elektrofuzzis/ftPwrDrive/wikifiles/img/poti.png

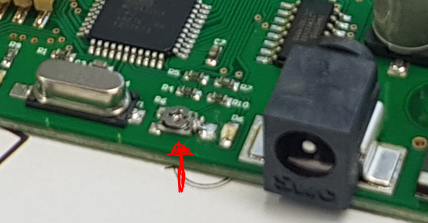
wikifiles/img/poti.png
