elektrofuzzis/ftPwrDrive/wikifiles/img/ROBOPro/microstepping.png

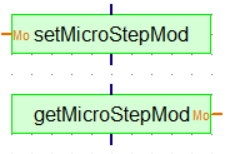
wikifiles/img/ROBOPro/microstepping.png
