elektrofuzzis/ftPwrDrive/README.md

# ftPwrDrive
The ftPwrDrive is a i²c based stepper motor driver for fischertechnik, Arduino &amp; Raspberry. The project contains the stepper motor drivers hardware, the firmware and interface libraries to use the hardware with multiple plattforms.

Please checkout the <a href="https://github.com/elektrofuzzis/ftPwrDrive/wiki">online manual</a>. Since the hardware is a complex smd pcb, you could buy a plug&play device at <a href="https://gundermann-software.de/shop/">gundermann.org</a>.

To check out the latest releases please follow up the <a href="https://github.com/elektrofuzzis/ftPwrDrive/wiki/Changelog">version history</a>.

<hr width="100%" />

Der ftPwrDrive ist ein Schrittmotortreiber für fischertechnik, Arduino &amp; Raspberry auf i²C-Basis. Das Projekt beinhaltet sowohl doe Schrittmotortreiberhardware und die notwendige Firmware als auch Interface Bibliotheken für unterschiedliche Plattformen.

Bitte lesen Sie das <a href="https://github.com/elektrofuzzis/ftPwrDrive/wiki">Online Manual</a>. Die Hardware besteht aus einer komplexen, SMD-bestückten Platine. Sie können den ftPwrDrive auch als fertiges Gerät bei <a href="https://gundermann-software.de/shop/">gundermann.org</a> bestellen.

Das Changelog für die aktuelle Version finden sie<a href="https://github.com/elektrofuzzis/ftPwrDrive/wiki/Changelog"> hier</a>.
