elektrofuzzis/ftPwrDrive/Arduino Library/readme.txt

To connect a ftPwrDrive to an Arduino board, please use the ftDuino implementation.
