elektrofuzzis/ftPwrDrive/wikifiles/img/arduino/motor_const.png

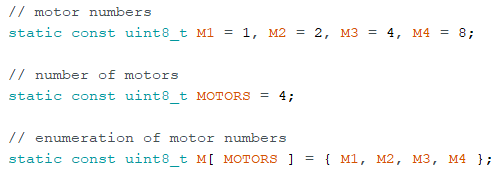
wikifiles/img/arduino/motor_const.png
