elektrofuzzis/ftPwrDrive/wikifiles/img/arduino/snippet2.png

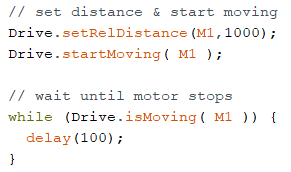
wikifiles/img/arduino/snippet2.png
