elektrofuzzis/ftPwrDrive/wikifiles/img/arduino/snippet3.png

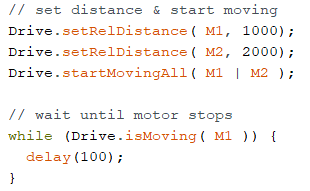
wikifiles/img/arduino/snippet3.png
