elektrofuzzis/ftPwrDrive/wikifiles/img/arduino/snippet8.png

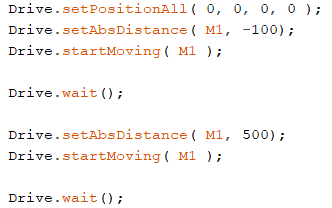
wikifiles/img/arduino/snippet8.png
