elektrofuzzis/ftPwrDrive/wikifiles/img/arduino/snippet9.png

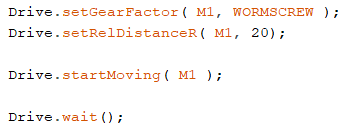
wikifiles/img/arduino/snippet9.png
