elektrofuzzis/ftPwrDrive/wikifiles/img/robopro1.png

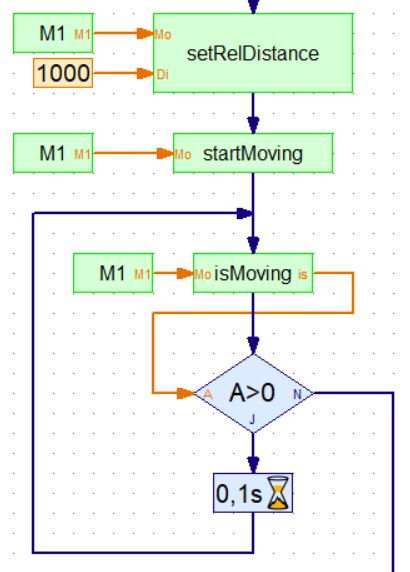
wikifiles/img/robopro1.png
