elektrofuzzis/ftPwrDrive/wikifiles/img/ROBOPro/gear_const.png

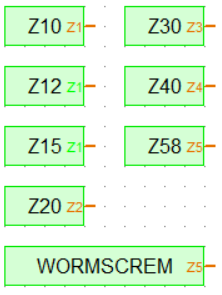
wikifiles/img/ROBOPro/gear_const.png
