elektrofuzzis/ftPwrDrive/wikifiles/img/ROBOPro/getPosition.png

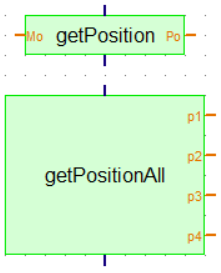
wikifiles/img/ROBOPro/getPosition.png
