elektrofuzzis/ftPwrDrive/wikifiles/img/ROBOPro/homing.png

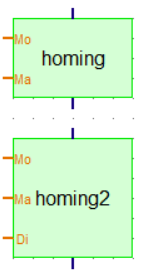
wikifiles/img/ROBOPro/homing.png
