elektrofuzzis/ftPwrDrive/wikifiles/img/ROBOPro/isMoving.png

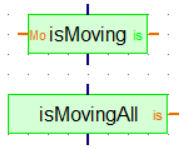
wikifiles/img/ROBOPro/isMoving.png
