elektrofuzzis/ftPwrDrive/wikifiles/img/ROBOPro/microstepping_const.png

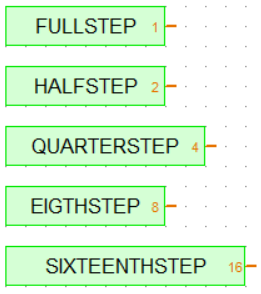
wikifiles/img/ROBOPro/microstepping_const.png
