elektrofuzzis/ftPwrDrive/wikifiles/img/ROBOPro/setAbsDistance.png

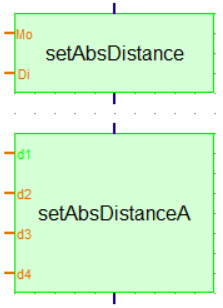
wikifiles/img/ROBOPro/setAbsDistance.png
