elektrofuzzis/ftPwrDrive/wikifiles/img/ROBOPro/setPosition.png

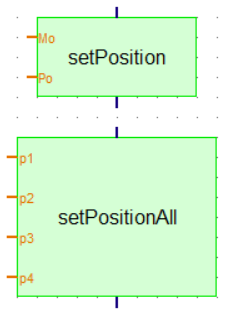
wikifiles/img/ROBOPro/setPosition.png
