elektrofuzzis/ftPwrDrive/wikifiles/img/ROBOPro/setRelDistance.png

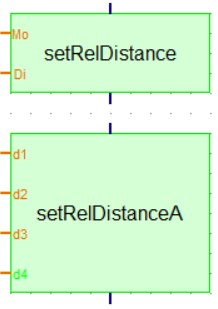
wikifiles/img/ROBOPro/setRelDistance.png
