elektrofuzzis/ftPwrDrive/wikifiles/img/ROBOPro/snippet1.png

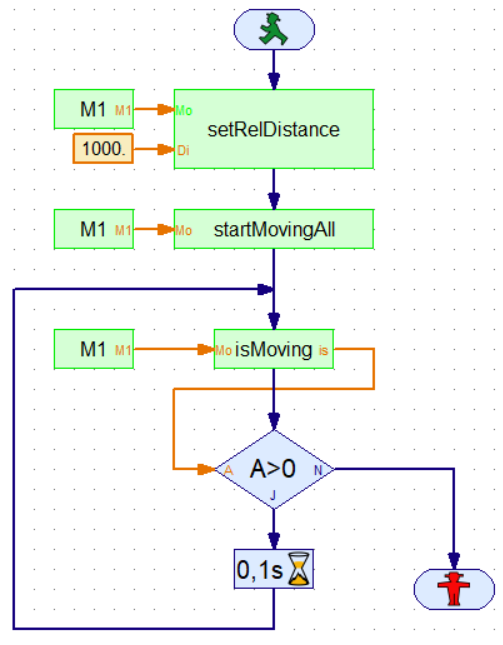
wikifiles/img/ROBOPro/snippet1.png
