elektrofuzzis/ftPwrDrive/wikifiles/img/ROBOPro/snippet2.png

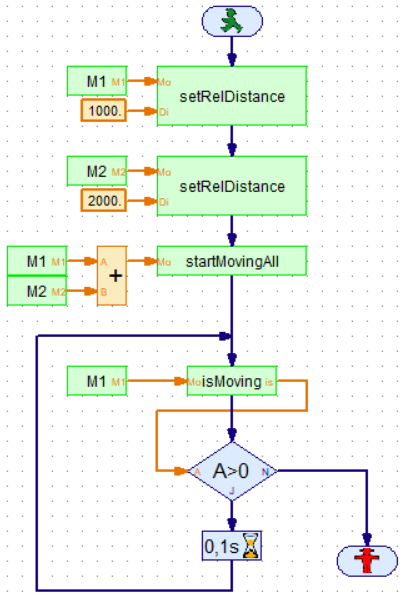
wikifiles/img/ROBOPro/snippet2.png
