elektrofuzzis/ftPwrDrive/wikifiles/img/ROBOPro/snippet3.png

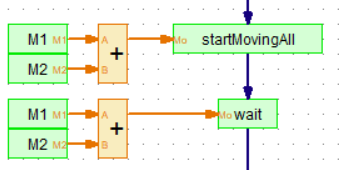
wikifiles/img/ROBOPro/snippet3.png
