elektrofuzzis/ftPwrDrive/wikifiles/img/ROBOPro/snippet5.png

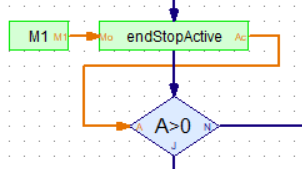
wikifiles/img/ROBOPro/snippet5.png
