elektrofuzzis/ftPwrDrive/wikifiles/img/ROBOPro/snippet6.png

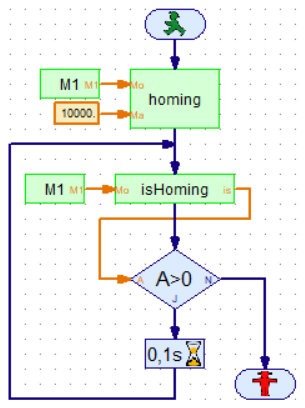
wikifiles/img/ROBOPro/snippet6.png
