elektrofuzzis/ftPwrDrive/wikifiles/img/ROBOPro/snippet7.png

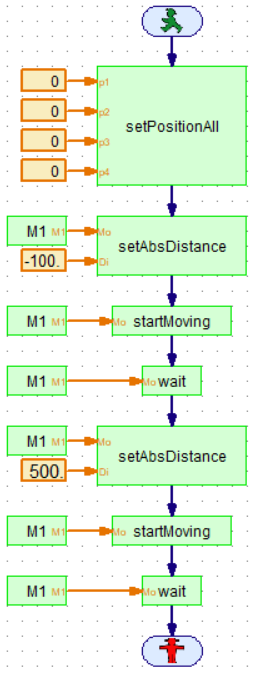
wikifiles/img/ROBOPro/snippet7.png
