elektrofuzzis/ftPwrDrive/wikifiles/img/ROBOPro/snippet8.png

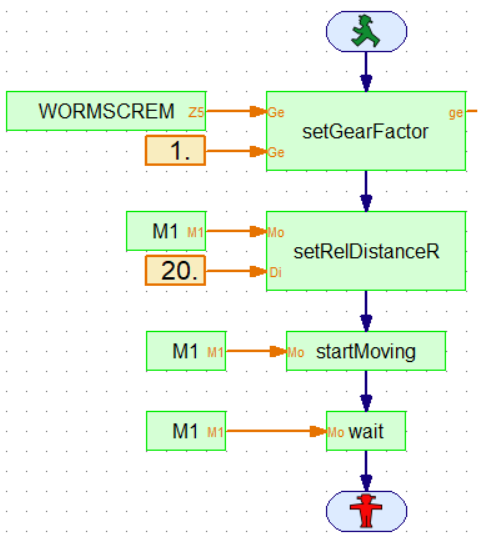
wikifiles/img/ROBOPro/snippet8.png
