elektrofuzzis/ftPwrDrive/wikifiles/img/ROBOPro/snippet10.png

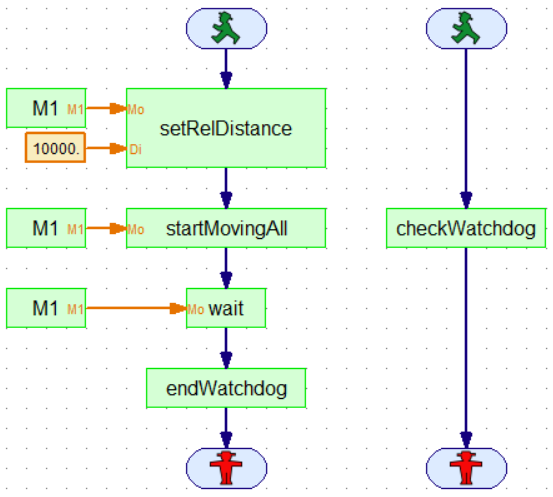
wikifiles/img/ROBOPro/snippet10.png
