elektrofuzzis/ftPwrDrive/wikifiles/img/ROBOPro/startMoving.png

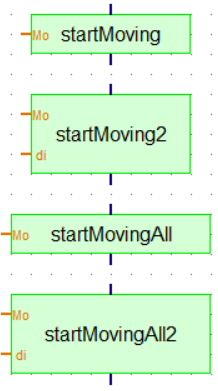
wikifiles/img/ROBOPro/startMoving.png
