elektrofuzzis/ftPwrDrive/wikifiles/img/ROBOPro/stopMoving.png

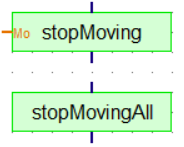
wikifiles/img/ROBOPro/stopMoving.png
