elektrofuzzis/ftPwrDrive/wikifiles/img/ROBOPro/watchdog.png

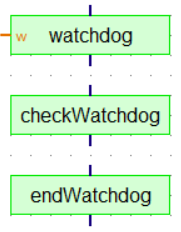
wikifiles/img/ROBOPro/watchdog.png
