elektrofuzzis/ftPwrDrive/wikifiles/img/servo1.png

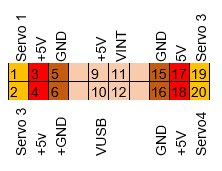
wikifiles/img/servo1.png
