elektrofuzzis/ftPwrDrive/wikifiles/img/maintenance.png

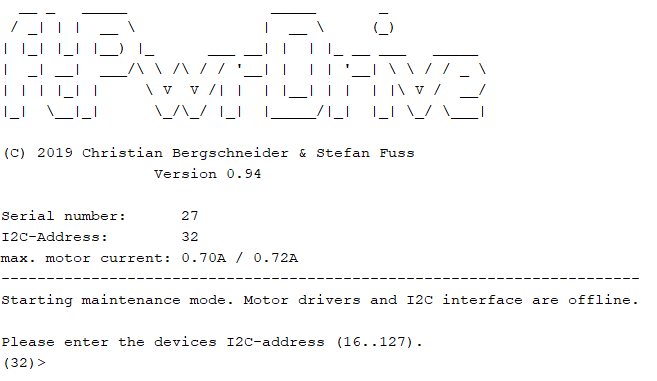
wikifiles/img/maintenance.png
