elektrofuzzis/ftPwrDrive/Hardware/Schematic/Schematic_Diagram.pdf

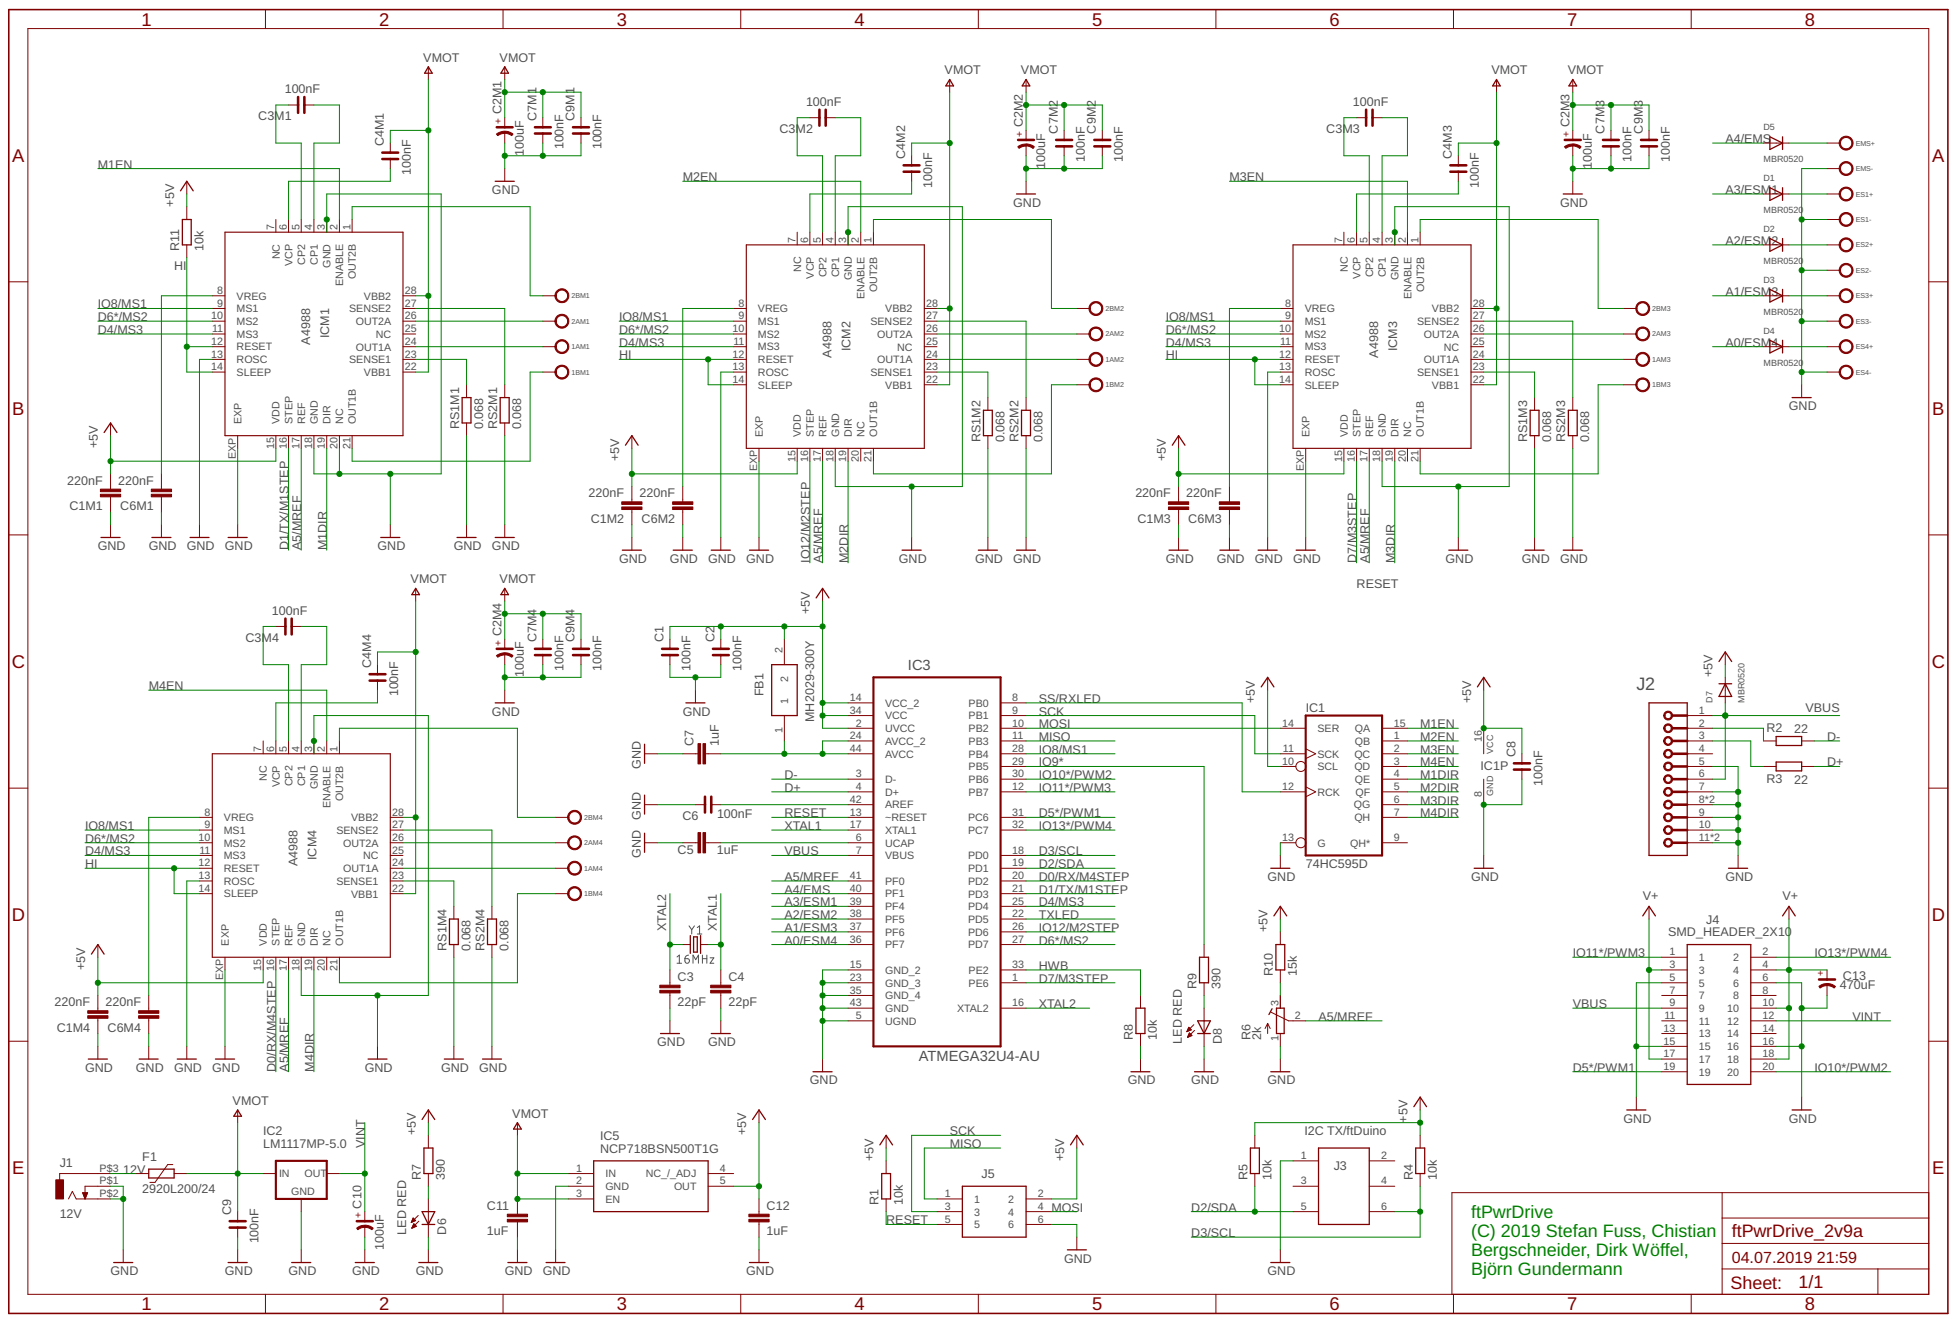
[picture p39: page 1]

LED RED GND ATMEGA32U4-AU

ftPwrDrive
(C) 2019 Stefan Fuss, Chistian Bergschneider, Dirk Wöffel, Björn Gundermann
