elektrofuzzis/ftPwrDrive/Hardware/Schematic/Layout.pdf

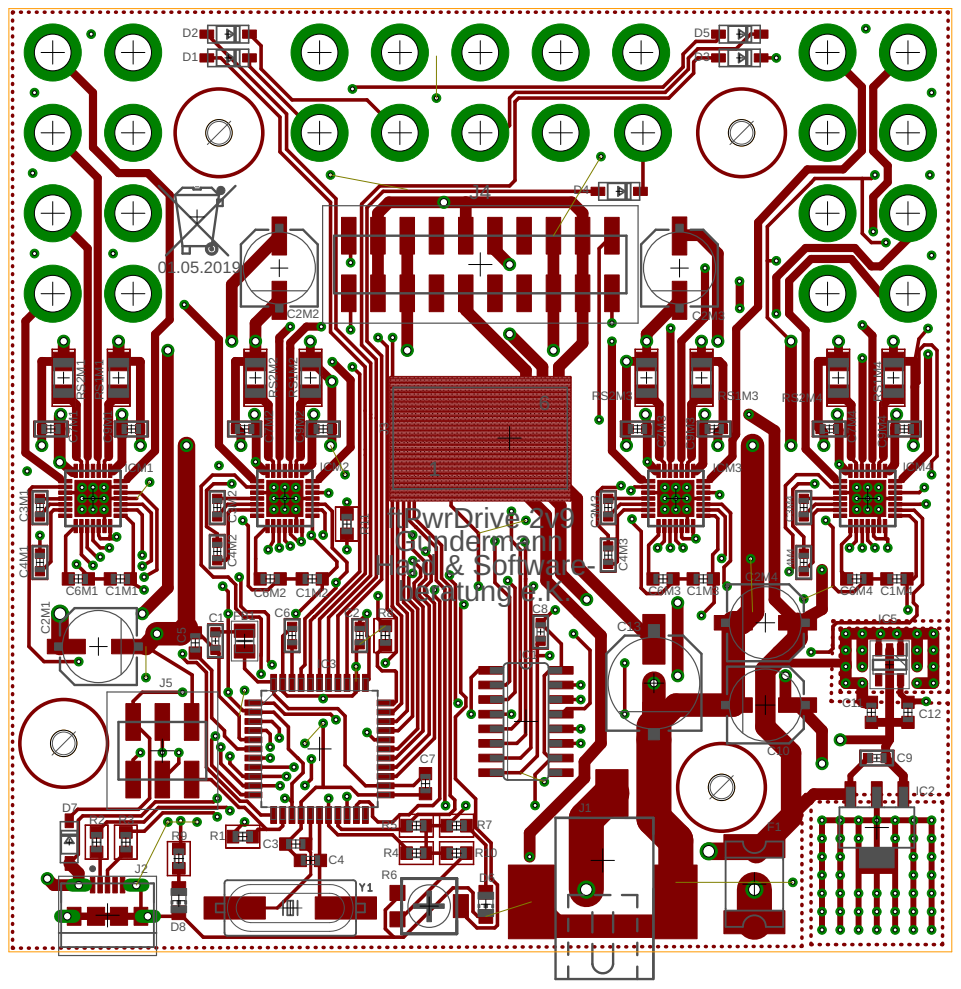
[picture p40: page 1]
