elektrofuzzis/ftPwrDrive/Hardware/Schematic/ftPwrDrive_2v9a.brd

## EAGLE design Hardware/Schematic/ftPwrDrive_2v9a.brd (2019-08-30)

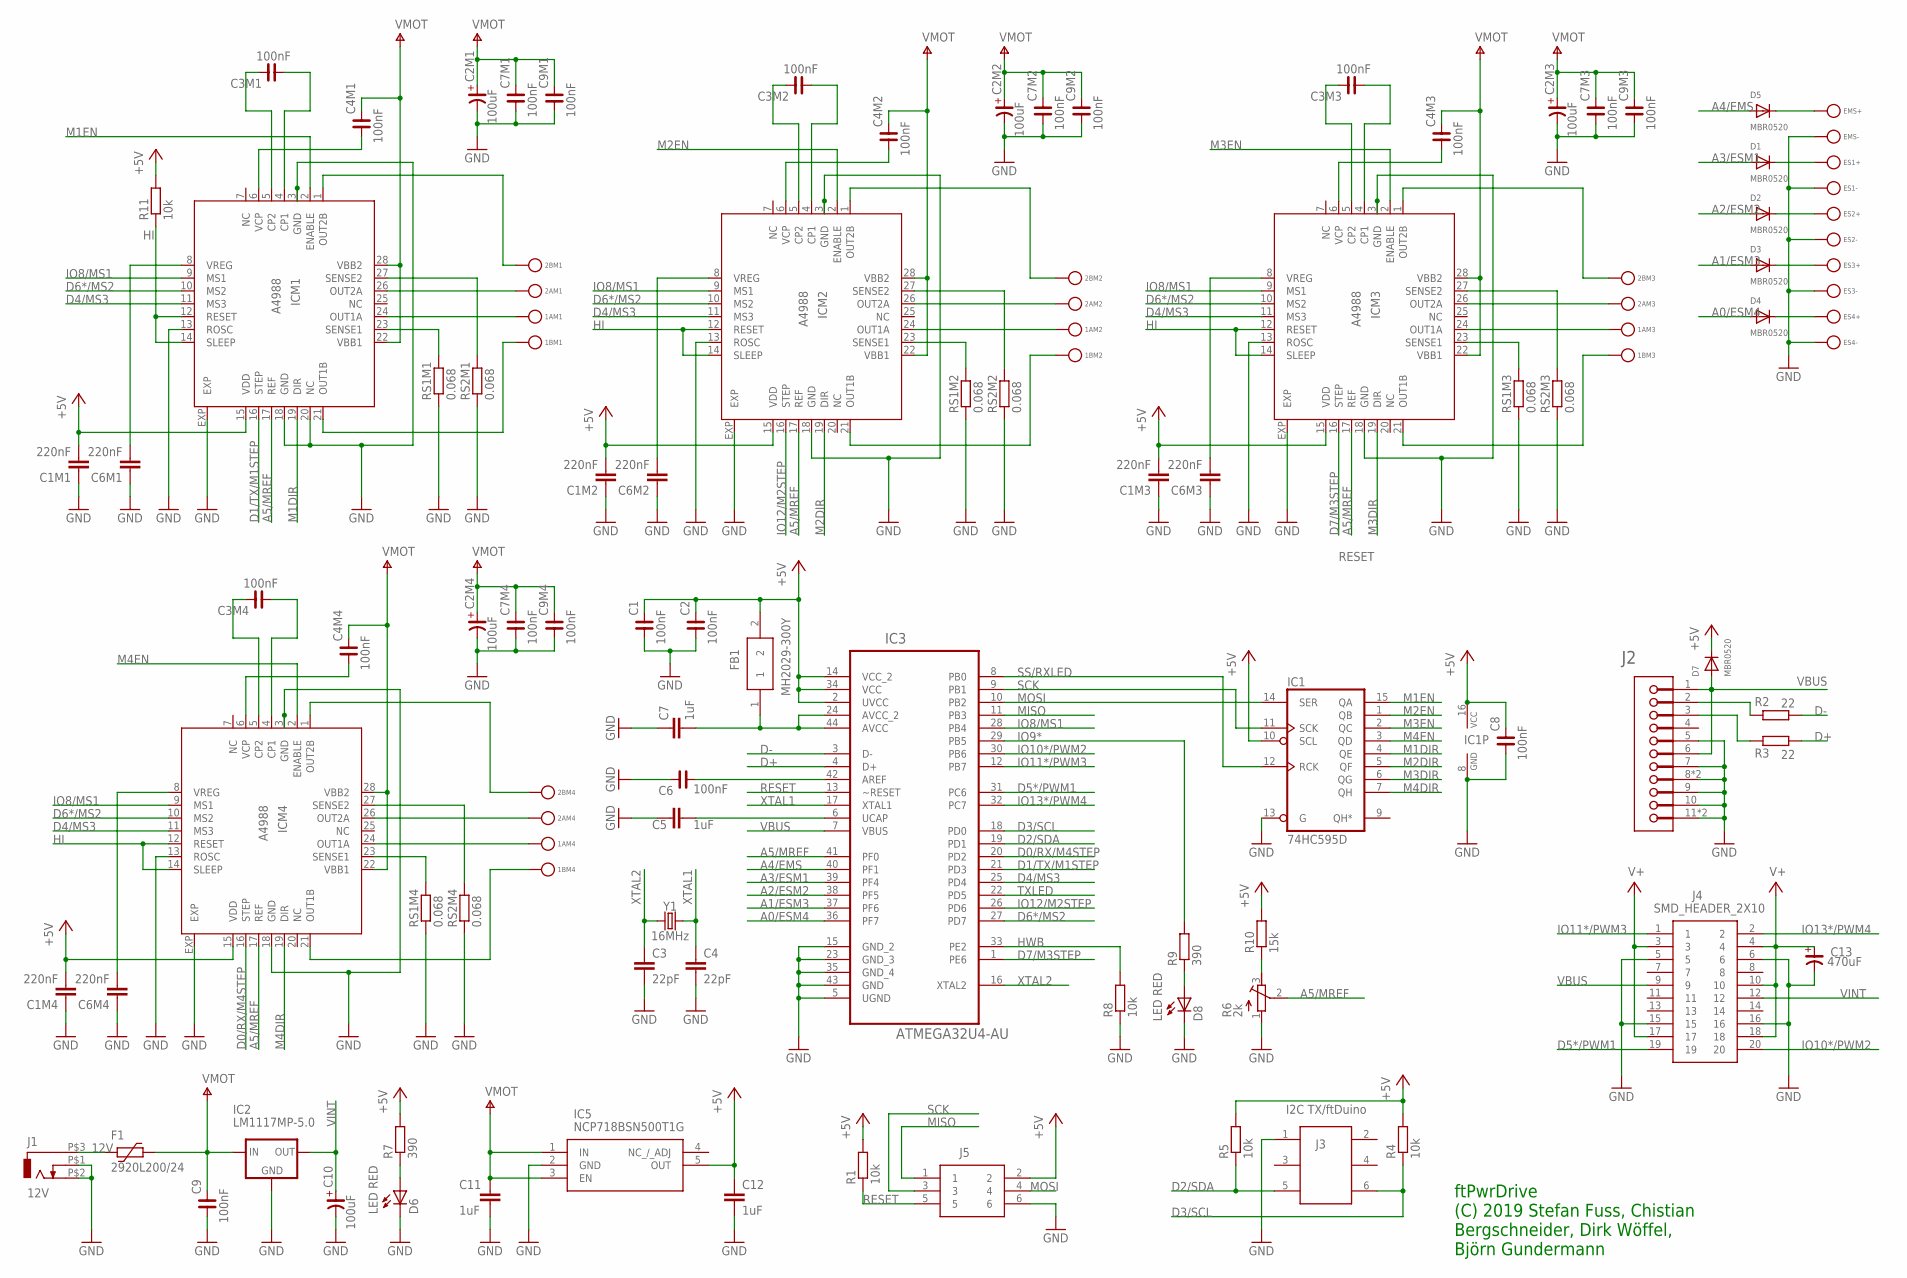
[picture p41: schematic ftPwrDrive_2v9a.sch]

Parts:
1AM1, 1AM2, 1AM3, 1AM4, 1BM1, 1BM2, 1BM3, 1BM4, 2AM1, 2AM2, 2AM3, 2AM4, 2BM1, 2BM2, 2BM3, 2BM4: BUNDHUELSE2; BUNDHUELSE
C1, C2, C3M1, C3M2, C3M3, C3M4, C4M1, C4M2, C4M3, C4M4, C6, C7M1, C7M2, C7M3, C7M4, C8, C9, C9M1, C9M2, C9M3, C9M4: 100nF; C0603
C1M1, C1M2, C1M3, C1M4, C6M1, C6M2, C6M3, C6M4: 220nF; C0603K
C2M1, C2M2, C2M3, C2M4, C10: 100uF; CSV-D
C3, C4: 22pF; C0603K
C5, C7, C11, C12: 1uF; C0603K
C13: 470uF; CSV-E/F
D1, D2, D3, D4, D5, D7: MBR0520; SOD-123
D6, D8: LED RED; CHIP-LED0805
EMS+: BUNDHUELSE2; BUNDHUELSE
EMS-: BUNDHUELSE2; BUNDHUELSE
ES1+, ES1-, ES2+, ES2-, ES3+, ES3-, ES4+, ES4-: BUNDHUELSE2; BUNDHUELSE
F1: 2920L200/24; 2920L
FB1: MH2029-300Y; BEADC2016X130N
IC1: 74HC595D; SO16
IC2: LM1117MP-5.0; SOT223
IC3: ATMEGA32U4-AU; QFP80P1200X1200X120-44N
IC5: NCP718BSN500T1G; SOT95P280X100-5N
ICM1, ICM2, ICM3, ICM4: A4988; QFN28ET
J1: 12V; RASM7X2
J2: AMPHENOL_10118194-0001LFAMPHENOL_10118194-0001LF_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; AMPHENOL_10118194-0001LF_0
J3: I2C TX/ftDuino; SMTHEADER06
J4: SMD_HEADER_2X10
J5: SMD_HEADER_2X03
R1, R4, R5, R8, R11: 10k; R0603
R2, R3: 22; R0603
R6: 2k; RTRIM4G/J
R7, R9: 390; R0603
R10: 15k; R0603
RS1M1, RS1M2, RS1M3, RS1M4, RS2M1, RS2M2, RS2M3, RS2M4: 0.068; R1206
Y1: 16MHz; HC49UP

Connections:
1AM1: 1AM1.P$1, ICM1.24 (OUT1A)
1AM2: 1AM2.P$1, ICM2.24 (OUT1A)
1AM3: 1AM3.P$1, ICM3.24 (OUT1A)
1AM4: 1AM4.P$1, ICM4.24 (OUT1A)
1BM1: 1BM1.P$1, ICM1.21 (OUT1B)
1BM2: 1BM2.P$1, ICM2.21 (OUT1B)
1BM3: 1BM3.P$1, ICM3.21 (OUT1B)
1BM4: 1BM4.P$1, ICM4.21 (OUT1B)
2AM1: 2AM1.P$1, ICM1.26 (OUT2A)
2AM2: 2AM2.P$1, ICM2.26 (OUT2A)
2AM3: 2AM3.P$1, ICM3.26 (OUT2A)
2AM4: 2AM4.P$1, ICM4.26 (OUT2A)
2BM1: 2BM1.P$1, ICM1.1 (OUT2B)
2BM2: 2BM2.P$1, ICM2.1 (OUT2B)
2BM3: 2BM3.P$1, ICM3.1 (OUT2B)
2BM4: 2BM4.P$1, ICM4.1 (OUT2B)
12V: F1.2, J1.P$3 (1)
+5V: C1.2, C1M1.2, C1M2.2, C1M3.2, C1M4.2, C2.2, C8.2, C12.1, D7.C, FB1.2, IC1.10 (SCL), IC1.16 (VCC), IC3.2 (UVCC), IC3.14 (VCC_2), IC3.34 (VCC), IC5.5 (OUT), ICM1.15 (VDD), ICM2.15 (VDD), ICM3.15 (VDD), ICM4.15 (VDD), J5.2, R1.2, R4.2, R5.2, R7.2, R10.2, R11.2
A0/ESM4: D4.A, IC3.36 (PF7)
A1/ESM3: D3.A, IC3.37 (PF6)
A2/ESM2: D2.A, IC3.38 (PF5)
A3/ESM1: D1.A, IC3.39 (PF4)
A4/EMS: D5.A, IC3.40 (PF1)
A5/MREF: IC3.41 (PF0), ICM1.17 (REF), ICM2.17 (REF), ICM3.17 (REF), ICM4.17 (REF), R6.2 (S)
D0/RX/M4STEP: IC3.20 (PD2), ICM4.16 (STEP)
D1/TX/M1STEP: IC3.21 (PD3), ICM1.16 (STEP)
D2/SDA: IC3.19 (PD1), J3.5, R5.1
D3/SCL: IC3.18 (PD0), J3.6, R4.1
D4/MS3: IC3.25 (PD4), ICM1.11 (MS3), ICM2.11 (MS3), ICM3.11 (MS3), ICM4.11 (MS3)
D5*/PWM1: IC3.31 (PC6), J4.19
D6*/MS2: IC3.27 (PD7), ICM1.10 (MS2), ICM2.10 (MS2), ICM3.10 (MS2), ICM4.10 (MS2)
D7/M3STEP: IC3.1 (PE6), ICM3.16 (STEP)
D+: IC3.4 (D+), R3.1
D-: IC3.3 (D-), R2.1
ES1+: D1.C, ES1+.P$1
ES1+1: D5.C, EMS+.P$1
ES2+: D2.C, ES2+.P$1
ES3+: D3.C, ES3+.P$1
ES4+: D4.C, ES4+.P$1
GND: C1.1, C1M1.1, C1M2.1, C1M3.1, C1M4.1, C2.1, C2M1.-, C2M2.-, C2M3.-, C2M4.-, C3.2, C4.2, C5.1, C6.1, C6M1.1, C6M2.1, C6M3.1, C6M4.1, C7.1, C7M1.1, C7M2.1, C7M3.1, C7M4.1, C8.1, C9.1, C9M1.1, C9M2.1, C9M3.1, C9M4.1, C10.-, C11.1, C12.2, C13.-, D6.C, D8.C, EMS-.P$1, ES1-.P$1, ES2-.P$1, ES3-.P$1, ES4-.P$1, IC1.8 (GND), IC1.13 (G), IC2.1 (GND), IC3.5 (UGND), IC3.15 (GND_2), IC3.23 (GND_3), IC3.35 (GND_4), IC3.43 (GND), IC5.2 (GND), ICM1.3 (GND), ICM1.13 (ROSC), ICM1.18 (GND), ICM1.20 (NC), ICM1.EXP, ICM2.3 (GND), ICM2.13 (ROSC), ICM2.18 (GND), ICM2.EXP, ICM3.3 (GND), ICM3.13 (ROSC), ICM3.18 (GND), ICM3.EXP, ICM4.3 (GND), ICM4.13 (ROSC), ICM4.18 (GND), ICM4.EXP, J1.P$1 (2), J1.P$2 (3), J2.5, J2.7 (MNT_2), J2.8 (MNT_3), J2.8-2 (MNT_3), J2.9 (MNT_4), J2.10 (MNT_5), J2.11 (MNT_6), J2.11-2 (MNT_6), J3.1, J4.5, J4.6, J4.15, J4.16, J5.6, R6.1 (A), R8.1, RS1M1.1, RS1M2.1, RS1M3.1, RS1M4.1, RS2M1.1, RS2M2.1, RS2M3.1, RS2M4.1
HI: ICM1.12 (RESET), ICM1.14 (SLEEP), ICM2.12 (RESET), ICM2.14 (SLEEP), ICM3.12 (RESET), ICM3.14 (SLEEP), ICM4.12 (RESET), ICM4.14 (SLEEP), R11.1
HWB: IC3.33 (PE2), R8.2
IO8/MS1: IC3.28 (PB4), ICM1.9 (MS1), ICM2.9 (MS1), ICM3.9 (MS1), ICM4.9 (MS1)
IO9*: IC3.29 (PB5), R9.2
IO10*/PWM2: IC3.30 (PB6), J4.20
IO11*/PWM3: IC3.12 (PB7), J4.1
IO12/M2STEP: IC3.26 (PD6), ICM2.16 (STEP)
IO13*/PWM4: IC3.32 (PC7), J4.2
M1DIR: IC1.4 (QE), ICM1.19 (DIR)
M1EN: IC1.15 (QA), ICM1.2 (ENABLE)
M2DIR: IC1.5 (QF), ICM2.19 (DIR)
M2EN: IC1.1 (QB), ICM2.2 (ENABLE)
M3DIR: IC1.6 (QG), ICM3.19 (DIR)
M3EN: IC1.2 (QC), ICM3.2 (ENABLE)
M4DIR: IC1.7 (QH), ICM4.19 (DIR)
M4EN: IC1.3 (QD), ICM4.2 (ENABLE)
MISO: IC3.11 (PB3), J5.1
MOSI: IC1.14 (SER), IC3.10 (PB2), J5.4
unnamed: J2.2, R2.2
unnamed: J2.3, R3.2
unnamed: D8.A, R9.1
unnamed: R6.3 (E), R10.1
unnamed: C5.2, IC3.6 (UCAP)
unnamed: C7.2, FB1.1, IC3.24 (AVCC_2), IC3.44 (AVCC)
unnamed: C6.2, IC3.42 (AREF)
unnamed: D6.A, R7.1
RESET: IC3.13 (~RESET), J5.5, R1.1
SCK: IC1.11 (SCK), IC3.9 (PB1), J5.3
SS/RXLED: IC1.12 (RCK), IC3.8 (PB0)
TXLED: IC3.22 (PD5)
V+: C13.+, J4.3, J4.4, J4.10, J4.17, J4.18
VBUS: D7.A, IC3.7 (VBUS), J2.1, J2.6 (MNT_1), J4.9
VINT: C10.+, IC2.2 (OUT), IC2.4 (OUT), J4.12
VMOT: C2M1.+, C2M2.+, C2M3.+, C2M4.+, C4M1.2, C4M2.2, C4M3.2, C4M4.2, C7M1.2, C7M2.2, C7M3.2, C7M4.2, C9.2, C9M1.2, C9M2.2, C9M3.2, C9M4.2, C11.2, F1.1, IC2.3 (IN), IC5.1 (IN), IC5.3 (EN), ICM1.22 (VBB1), ICM1.28 (VBB2), ICM2.22 (VBB1), ICM2.28 (VBB2), ICM3.22 (VBB1), ICM3.28 (VBB2), ICM4.22 (VBB1), ICM4.28 (VBB2)
XCP1: C3M1.1, ICM1.4 (CP1)
XCP2: C3M1.2, ICM1.5 (CP2)
XCP5: C3M2.1, ICM2.4 (CP1)
XCP6: C3M2.2, ICM2.5 (CP2)
XCP7: C3M3.1, ICM3.4 (CP1)
XCP8: C3M3.2, ICM3.5 (CP2)
XCP9: C3M4.1, ICM4.4 (CP1)
XCP10: C3M4.2, ICM4.5 (CP2)
XSENSE1: ICM1.23 (SENSE1), RS1M1.2
XSENSE2: ICM1.27 (SENSE2), RS2M1.2
XSENSE5: ICM2.27 (SENSE2), RS2M2.2
XSENSE6: ICM2.23 (SENSE1), RS1M2.2
XSENSE7: ICM3.27 (SENSE2), RS2M3.2
XSENSE8: ICM3.23 (SENSE1), RS1M3.2
XSENSE9: ICM4.27 (SENSE2), RS2M4.2
XSENSE10: ICM4.23 (SENSE1), RS1M4.2
XTAL1: C4.1, IC3.17 (XTAL1), Y1.2
XTAL2: C3.1, IC3.16 (XTAL2), Y1.1
XVCP: C4M1.1, ICM1.6 (VCP)
XVCP2: C4M2.1, ICM2.6 (VCP)
XVCP3: C4M3.1, ICM3.6 (VCP)
XVCP4: C4M4.1, ICM4.6 (VCP)
XVREG: C6M1.2, ICM1.8 (VREG)
XVREG2: C6M2.2, ICM2.8 (VREG)
XVREG3: C6M3.2, ICM3.8 (VREG)
XVREG4: C6M4.2, ICM4.8 (VREG)

Notes on the sheet:
ftPwrDrive (C) 2019 Stefan Fuss, Chistian Bergschneider, Dirk Wöffel, Björn Gundermann

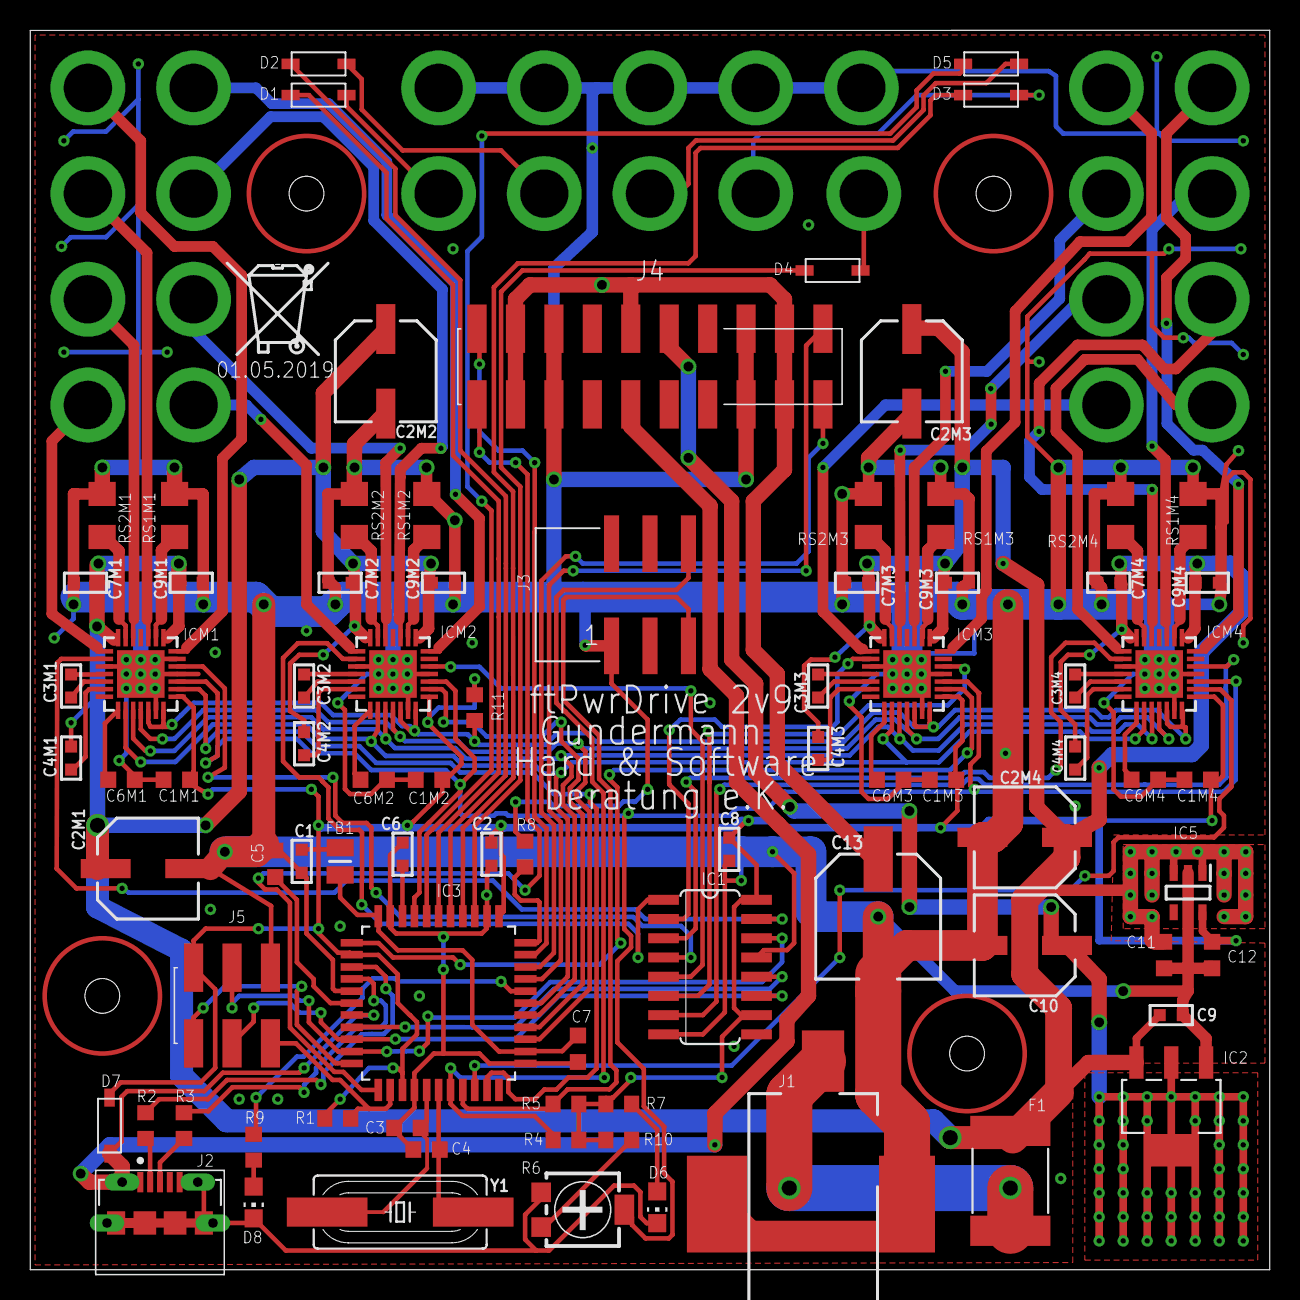
[picture p42: board ftPwrDrive_2v9a.brd from above]

Board: 2 copper layers, 81.9 x 81.9 mm, 111 parts (0 on the bottom side), 99 nets.

Other parts of the board:
U$9: ROHS_BIN
