elektrofuzzis/ftPwrDrive/(commit log)

2019-08-30 initial version 0.9
    [ftPwrDrive_2v9a.brd, ftPwrDrive_2v9a.sch]
2019-08-31 hex firmware added
    [ftPwrDrive_2v9a.brd, ftPwrDrive_2v9a.sch]
2019-09-05 FW V0.91 - servo support
2019-09-17 Add files via upload
    Initiale Version des Handbuches mit Beschreibung für die Firmware V0.92
2019-12-31 Version 0.94
    - Use with firmware 0.94 or higher
    - bugfix watchdog (firmware)
    - constants without FTPWRDRIVE, e.g. M1 instead of FTPWRDRIVE_M1
    - new funtions setGearFactor, setRelDistanceR, setAbsDistanceR
    [ftPwrDrive.cpp, ftPwrDriveFW.ino]
